Soumyajit21213/Gujarat_Robofest_Maze_Solver/PCB Design /PCB_PCB_MAZE_RUNNER_4_2024-06-20.png

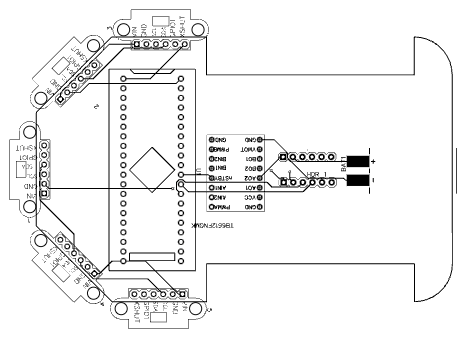
PCB Design /PCB_PCB_MAZE_RUNNER_4_2024-06-20.png
