Soumyajit21213/Gujarat_Robofest_Maze_Solver/ARDUINO CODES/Hardware Basic Codes/mpu6050/mpu6050.ino

/*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
1.0  14 January 2023 -  initial release
*/
#include <Wire.h>
float RateRoll, RatePitch, RateYaw;
float RateCalibrationRoll, RateCalibrationPitch, RateCalibrationYaw;
int RateCalibrationNumber;
#include <PulsePosition.h>
PulsePositionInput ReceiverInput(RISING);
float ReceiverValue[]={0, 0, 0, 0, 0, 0, 0, 0};
int ChannelNumber=0; 
float Voltage, Current, BatteryRemaining, BatteryAtStart;
float CurrentConsumed=0;
float BatteryDefault=1300;
uint32_t LoopTimer;
float DesiredRateRoll, DesiredRatePitch,DesiredRateYaw;
float ErrorRateRoll, ErrorRatePitch, ErrorRateYaw;
float InputRoll, InputThrottle, InputPitch, InputYaw;
float PrevErrorRateRoll, PrevErrorRatePitch, PrevErrorRateYaw;
float PrevItermRateRoll, PrevItermRatePitch, PrevItermRateYaw;
float PIDReturn[]={0, 0, 0};
float PRateRoll=0.6; float PRatePitch=PRateRoll; float PRateYaw=2;
float IRateRoll=3.5; float IRatePitch=IRateRoll; float IRateYaw=12;
float DRateRoll=0.03; float DRatePitch=DRateRoll; float DRateYaw=0;
float MotorInput1, MotorInput2, MotorInput3, MotorInput4;
float AccX, AccY, AccZ;
float AngleRoll, AnglePitch;
float KalmanAngleRoll=0, KalmanUncertaintyAngleRoll=2*2;
float KalmanAnglePitch=0, KalmanUncertaintyAnglePitch=2*2;
float Kalman1DOutput[]={0,0};
float DesiredAngleRoll, DesiredAnglePitch;
float ErrorAngleRoll, ErrorAnglePitch;
float PrevErrorAngleRoll, PrevErrorAnglePitch;
float PrevItermAngleRoll, PrevItermAnglePitch;
float PAngleRoll=2; float PAnglePitch=PAngleRoll;
float IAngleRoll=0; float IAnglePitch=IAngleRoll;
float DAngleRoll=0; float DAnglePitch=DAngleRoll;
void kalman_1d(float KalmanState, float KalmanUncertainty, float KalmanInput, float KalmanMeasurement) {
  KalmanState=KalmanState+0.004*KalmanInput;
  KalmanUncertainty=KalmanUncertainty + 0.004 * 0.004 * 4 * 4;
  float KalmanGain=KalmanUncertainty * 1/(1*KalmanUncertainty + 3 * 3);
  KalmanState=KalmanState+KalmanGain * (KalmanMeasurement-KalmanState);
  KalmanUncertainty=(1-KalmanGain) * KalmanUncertainty;
  Kalman1DOutput[0]=KalmanState; 
  Kalman1DOutput[1]=KalmanUncertainty;
}
void battery_voltage(void) {
  Voltage=(float)analogRead(15)/62;
  Current=(float)analogRead(21)*0.089;
}
void read_receiver(void){
  ChannelNumber = ReceiverInput.available();  
  if (ChannelNumber > 0) {
         for (int i=1; i<=ChannelNumber;i++){
              ReceiverValue[i-1]=ReceiverInput.read(i);
         }
  }
}
void gyro_signals(void) {
  Wire.beginTransmission(0x68);
  Wire.write(0x1A);
  Wire.write(0x05);
  Wire.endTransmission();
  Wire.beginTransmission(0x68);
  Wire.write(0x1C);
  Wire.write(0x10);
  Wire.endTransmission();
  Wire.beginTransmission(0x68);
  Wire.write(0x3B);
  Wire.endTransmission(); 
  Wire.requestFrom(0x68,6);
  int16_t AccXLSB = Wire.read() << 8 | Wire.read();
  int16_t AccYLSB = Wire.read() << 8 | Wire.read();
  int16_t AccZLSB = Wire.read() << 8 | Wire.read();
  Wire.beginTransmission(0x68);
  Wire.write(0x1B); 
  Wire.write(0x8);
  Wire.endTransmission();                                                   
  Wire.beginTransmission(0x68);
  Wire.write(0x43);
  Wire.endTransmission();
  Wire.requestFrom(0x68,6);
  int16_t GyroX=Wire.read()<<8 | Wire.read();
  int16_t GyroY=Wire.read()<<8 | Wire.read();
  int16_t GyroZ=Wire.read()<<8 | Wire.read();
  RateRoll=(float)GyroX/65.5;
  RatePitch=(float)GyroY/65.5;
  RateYaw=(float)GyroZ/65.5;
  AccX=(float)AccXLSB/4096;
  AccY=(float)AccYLSB/4096;
  AccZ=(float)AccZLSB/4096 -0.21 ;
  AngleRoll=atan(AccY/sqrt(AccX*AccX+AccZ*AccZ))*1/(3.142/180);
  AnglePitch=-atan(AccX/sqrt(AccY*AccY+AccZ*AccZ))*1/(3.142/180);
}
void pid_equation(float Error, float P , float I, float D, float PrevError, float PrevIterm) {
  float Pterm=P*Error;
  float Iterm=PrevIterm+I*(Error+PrevError)*0.004/2;
  if (Iterm > 400) Iterm=400;
  else if (Iterm <-400) Iterm=-400;
  float Dterm=D*(Error-PrevError)/0.004;
  float PIDOutput= Pterm+Iterm+Dterm;
  if (PIDOutput>400) PIDOutput=400;
  else if (PIDOutput <-400) PIDOutput=-400;
  PIDReturn[0]=PIDOutput;
  PIDReturn[1]=Error;
  PIDReturn[2]=Iterm;
}
void reset_pid(void) {
  PrevErrorRateRoll=0; PrevErrorRatePitch=0; PrevErrorRateYaw=0;
  PrevItermRateRoll=0; PrevItermRatePitch=0; PrevItermRateYaw=0;
  PrevErrorAngleRoll=0; PrevErrorAnglePitch=0;    
  PrevItermAngleRoll=0; PrevItermAnglePitch=0;
}
void setup() {
  pinMode(5, OUTPUT);
  digitalWrite(5, HIGH);
  pinMode(13, OUTPUT);
  digitalWrite(13, HIGH);   
  Wire.setClock(400000);
  Wire.begin();
  delay(250);
  Wire.beginTransmission(0x68);
  Wire.write(0x6B);
  Wire.write(0x00);
  Wire.endTransmission();
  for (RateCalibrationNumber=0; 
        RateCalibrationNumber<2000;
        RateCalibrationNumber ++) {
          gyro_signals();
    RateCalibrationRoll+=RateRoll;
    RateCalibrationPitch+=RatePitch;
    RateCalibrationYaw+=RateYaw;
    delay(1);
  }
  RateCalibrationRoll/=2000;
  RateCalibrationPitch/=2000;
  RateCalibrationYaw/=2000;
  analogWriteFrequency(1, 250);
  analogWriteFrequency(2, 250);
  analogWriteFrequency(3, 250);
  analogWriteFrequency(4, 250);
  analogWriteResolution(12,
12);
  pinMode(6, OUTPUT);
  digitalWrite(6, HIGH);
  battery_voltage();
  if (Voltage > 8.3) { digitalWrite(5, LOW); BatteryAtStart=BatteryDefault; }
  else if (Voltage < 7.5) {BatteryAtStart=30/100*BatteryDefault ;}
  else { digitalWrite(5, LOW); BatteryAtStart=(82*Voltage-580)/100*BatteryDefault; }
  ReceiverInput.begin(14);
  while (ReceiverValue[2] < 1020 || 
         ReceiverValue[2] > 1050) {
    read_receiver();
    delay(4);
  }
  LoopTimer=micros();
}
void loop() {
  gyro_signals();
  RateRoll-=RateCalibrationRoll;
  RatePitch-=RateCalibrationPitch;
  RateYaw-=RateCalibrationYaw;
  kalman_1d(KalmanAngleRoll, KalmanUncertaintyAngleRoll, RateRoll, AngleRoll);
  KalmanAngleRoll=Kalman1DOutput[0]; KalmanUncertaintyAngleRoll=Kalman1DOutput[1];
  kalman_1d(KalmanAnglePitch, KalmanUncertaintyAnglePitch, RatePitch, AnglePitch);
  KalmanAnglePitch=Kalman1DOutput[0]; KalmanUncertaintyAnglePitch=Kalman1DOutput[1];
  read_receiver();
  DesiredAngleRoll=0.10*(ReceiverValue[0]-1500);
  DesiredAnglePitch=0.10*(ReceiverValue[1]-1500);
  InputThrottle=ReceiverValue[2];
  DesiredRateYaw=0.15*(ReceiverValue[3]-1500);
  ErrorAngleRoll=DesiredAngleRoll-KalmanAngleRoll;
  ErrorAnglePitch=DesiredAnglePitch-KalmanAnglePitch;
  pid_equation(ErrorAngleRoll, PAngleRoll, IAngleRoll, DAngleRoll, PrevErrorAngleRoll, PrevItermAngleRoll);     
  DesiredRateRoll=PIDReturn[0]; 
  PrevErrorAngleRoll=PIDReturn[1];
  PrevItermAngleRoll=PIDReturn[2];
  pid_equation(ErrorAnglePitch, PAnglePitch, IAnglePitch, DAnglePitch, PrevErrorAnglePitch, PrevItermAnglePitch);
  DesiredRatePitch=PIDReturn[0]; 
  PrevErrorAnglePitch=PIDReturn[1];
  PrevItermAnglePitch=PIDReturn[2];
  ErrorRateRoll=DesiredRateRoll-RateRoll;
  ErrorRatePitch=DesiredRatePitch-RatePitch;
  ErrorRateYaw=DesiredRateYaw-RateYaw;
  pid_equation(ErrorRateRoll, PRateRoll, IRateRoll, DRateRoll, PrevErrorRateRoll, PrevItermRateRoll);
       InputRoll=PIDReturn[0];
       PrevErrorRateRoll=PIDReturn[1]; 
       PrevItermRateRoll=PIDReturn[2];
  pid_equation(ErrorRatePitch, PRatePitch,IRatePitch, DRatePitch, PrevErrorRatePitch, PrevItermRatePitch);
       InputPitch=PIDReturn[0]; 
       PrevErrorRatePitch=PIDReturn[1]; 
       PrevItermRatePitch=PIDReturn[2];
  pid_equation(ErrorRateYaw, PRateYaw,IRateYaw, DRateYaw, PrevErrorRateYaw, PrevItermRateYaw);
       InputYaw=PIDReturn[0]; 
       PrevErrorRateYaw=PIDReturn[1]; 
       PrevItermRateYaw=PIDReturn[2];/* 
  MPU6050 DMP6 ESPWiFi

  The board reads quaternion data from the MPU6050 and sends Open Sound
  Control messages.

  This example requires the WiFiManager and OSCMEssage libraries available here:
  - https://github.com/tzapu/WiFiManager
  - https://github.com/CNMAT/OSC 

  Digital Motion Processor or DMP performs complex motion processing tasks.
  - Fuses the data from the accel, gyro, and external magnetometer if applied, 
  compensating individual sensor noise and errors.
  - Detect specific types of motion without the need to continuously monitor 
  raw sensor data with a microcontroller.
  - Reduce workload on the microprocessor.
  - Output processed data such as quaternions, Euler angles, and gravity vectors.

  The code includes auto-calibration and offsets generator tasks. Different 
  output formats available.

  This code is compatible with the teapot project by using the teapot output format.

  Circuit: In addition to connection 3.3v, GND, SDA, and SCL, this sketch
  depends on the MPU6050's INT pin being connected to the board's
  external interrupt #0 pin.
    
  Find the full MPU6050 library documentation here:
  https://github.com/ElectronicCats/mpu6050/wiki

*/

#if defined(ESP8266) 
#include <ESP8266WiFi.h> // Include this library if using an ESP8266 based board
#else
#include <WiFi.h> //Otherwise use the included WiFi library
#endif

#include <DNSServer.h>
#include <WiFiClient.h>
#include <WiFiUdp.h>
#include <OSCMessage.h>
#include <WiFiManager.h>

#include "I2Cdev.h"
#include "MPU6050_6Axis_MotionApps20.h"

/* MPU6050 default I2C address is 0x68*/
MPU6050 mpu;
//MPU6050 mpu(0x69); //Use for AD0 high
//MPU6050 mpu(0x68, &Wire1); //Use for AD0 low, but 2nd Wire (TWI/I2C) object.

/* OUTPUT FORMAT DEFINITION-------------------------------------------------------------------------------------------
- Use "OUTPUT_READABLE_QUATERNION" for quaternion commponents in [w, x, y, z] format. Quaternion does not 
suffer from gimbal lock problems but is harder to parse or process efficiently on a remote host or software 
environment like Processing.

- Use "OUTPUT_READABLE_EULER" for Euler angles (in degrees) output, calculated from the quaternions coming 
from the FIFO. EULER ANGLES SUFFER FROM GIMBAL LOCK PROBLEM.

- Use "OUTPUT_READABLE_YAWPITCHROLL" for yaw/pitch/roll angles (in degrees) calculated from the quaternions
coming from the FIFO. THIS REQUIRES GRAVITY VECTOR CALCULATION.
YAW/PITCH/ROLL ANGLES SUFFER FROM GIMBAL LOCK PROBLEM.

- Use "OUTPUT_READABLE_REALACCEL" for acceleration components with gravity removed. The accel reference frame
is not compensated for orientation. +X will always be +X according to the sensor.

- Use "OUTPUT_READABLE_WORLDACCEL" for acceleration components with gravity removed and adjusted for the world
reference frame. Yaw is relative if there is no magnetometer present.

-  Use "OUTPUT_TEAPOT_OSC" for output that matches the InvenSense teapot demo. 
-------------------------------------------------------------------------------------------------------------------------------*/ 
// #define OUTPUT_TEAPOT_OSC
#define OUTPUT_READABLE_YAWPITCHROLL
//#define OUTPUT_READABLE_QUATERNION
//#define OUTPUT_READABLE_EULER
//#define OUTPUT_READABLE_REALACCEL
//#define OUTPUT_READABLE_WORLDACCEL

#ifdef OUTPUT_READABLE_EULER
float euler[3];         // [psi, theta, phi]    Euler angle container
#endif
#ifdef OUTPUT_READABLE_YAWPITCHROLL
float ypr[3];           // [yaw, pitch, roll]   Yaw/Pitch/Roll container and gravity vector
#endif

#define INTERRUPT_PIN 15 //define the INT pin on your board

/*---MPU6050 Control/Status Variables---*/
bool DMPReady = false;  // Set true if DMP init was successful
uint8_t MPUIntStatus;   // Holds actual interrupt status byte from MPU
uint8_t devStatus;      // Return status after each device operation (0 = success, !0 = error)
uint16_t packetSize;    // Expected DMP packet size (default is 42 bytes)
uint16_t FIFOCount;     // Count of all bytes currently in FIFO
uint8_t FIFOBuffer[64]; // FIFO storage buffer

/*---Orientation/Motion Variables---*/ 
Quaternion q;           // [w, x, y, z]         Quaternion container
VectorInt16 aa;         // [x, y, z]            Accel sensor measurements
VectorInt16 aaReal;     // [x, y, z]            Gravity-free accel sensor measurements
VectorInt16 aaWorld;    // [x, y, z]            World-frame accel sensor measurements
VectorFloat gravity;    // [x, y, z]            Gravity vector

const char DEVICE_NAME[] = "mpu6050";

WiFiUDP UDP;                                // A  instance to let us send and receive packets over 
const IPAddress outIp(192, 168, 1, 11);     // Remote IP to receive OSC
const unsigned int outPort = 9999;          // Remote port to receive OSC

/*------Interrupt detection routine------*/
volatile bool MPUInterrupt = false;     // Indicates whether MPU6050 interrupt pin has gone high
void ICACHE_RAM_ATTR DMPDataReady() {
  MPUInterrupt = true;
}

void mpu_setup(){
#if I2CDEV_IMPLEMENTATION == I2CDEV_ARDUINO_WIRE
  Wire.begin();
  Wire.setClock(400000); // 400kHz I2C clock. Comment this line if having compilation difficulties
#elif I2CDEV_IMPLEMENTATION == I2CDEV_BUILTIN_FASTWIRE
  Fastwire::setup(400, true);
#endif

  // Initialize device
  Serial.println(F("Initializing I2C devices..."));
  mpu.initialize();
  pinMode(INTERRUPT_PIN, INPUT);

  /*Verify connection*/
  Serial.println(F("Testing MPU6050 connection..."));
  if(mpu.testConnection() == false){
    Serial.println("MPU6050 connection failed");
    while(true);
  }
    else {
    Serial.println("MPU6050 connection successful");
  }

  /* Initializate and configure the DMP*/
  Serial.println(F("Initializing DMP..."));
  devStatus = mpu.dmpInitialize();

  /* Supply your gyro offsets here, scaled for min sensitivity */
  mpu.setXGyroOffset(0);
  mpu.setYGyroOffset(0);
  mpu.setZGyroOffset(0);
  mpu.setZAccelOffset(0);

  /* Making sure it worked (returns 0 if so) */ 
  if (devStatus == 0) {
    mpu.CalibrateAccel(6);  // Calibration Time: generate offsets and calibrate our MPU6050
    mpu.CalibrateGyro(6);
    Serial.println("These are the Active offsets: ");
    mpu.PrintActiveOffsets();
    Serial.println(F("Enabling DMP..."));   //Turning ON DMP
    mpu.setDMPEnabled(true);

    /*Enable Arduino interrupt detection*/
    Serial.print(F("Enabling interrupt detection (Arduino external interrupt "));
    Serial.print(digitalPinToInterrupt(INTERRUPT_PIN));
    Serial.println(F(")..."));
    attachInterrupt(digitalPinToInterrupt(INTERRUPT_PIN), DMPDataReady, RISING);
    MPUIntStatus = mpu.getIntStatus();

    /* Set the DMP Ready flag so the main loop() function knows it is okay to use it */
    Serial.println(F("DMP ready! Waiting for first interrupt..."));
    DMPReady = true;
    packetSize = mpu.dmpGetFIFOPacketSize(); //Get expected DMP packet size for later comparison
  } 
  else {
    Serial.print(F("DMP Initialization failed (code ")); //Print the error code
    Serial.print(devStatus);
    Serial.println(F(")"));
    // 1 = initial memory load failed
    // 2 = DMP configuration updates failed
  }
}

void mpu_loop()
{
  if (!DMPReady) return; // Stop the program if DMP programming fails.
  if (!MPUInterrupt && FIFOCount < packetSize) return; // Wait for MPU interrupt or extra packet(s) available

  /*Reset interrupt flag and get INT_STATUS byte*/
  MPUInterrupt = false;
  MPUIntStatus = mpu.getIntStatus();

  FIFOCount = mpu.getFIFOCount();  // Get current FIFO count

  /*Check for overflow (this should never happen unless our code is too inefficient)*/
  if ((MPUIntStatus & 0x10) || FIFOCount == 1024) {
    mpu.resetFIFO();     //Reset so we can continue cleanly
    Serial.println(F("FIFO overflow!"));
    //*Otherwise, check for DMP data ready interrupt (this should happen frequently)*/
  } 
  else if (MPUIntStatus & 0x02) {
    while (FIFOCount < packetSize) FIFOCount = mpu.getFIFOCount();    // Wait for correct available data length, should be a VERY short wait
    mpu.getFIFOBytes(FIFOBuffer, packetSize);    //Read a packet from FIFO
    // track FIFO count here in case there is > 1 packet available
    // (this lets us immediately read more without waiting for an interrupt)
    FIFOCount -= packetSize;
    #ifdef OUTPUT_READABLE_QUATERNION
      /* Display Quaternion values in easy matrix form: [w, x, y, z] */
      mpu.dmpGetQuaternion(&q, FIFOBuffer);
      Serial.print("quat\t");
      Serial.print(q.w);
      Serial.print("\t");
      Serial.print(q.x);
      Serial.print("\t");
      Serial.print(q.y);
      Serial.print("\t");
      Serial.println(q.z);
    #endif

    #ifdef OUTPUT_TEAPOT_OSC
      #ifndef OUTPUT_READABLE_QUATERNION
        /* Display Quaternion values in easy matrix form: [w, x, y, z] */
        mpu.dmpGetQuaternion(&q, FIFOBuffer);
      #endif
      /*Send OSC message*/
      OSCMessage msg("/imuquat");
      msg.add((float)q.w);
      msg.add((float)q.x);
      msg.add((float)q.y);
      msg.add((float)q.z);

      UDP.beginPacket(outIp, outPort);
      msg.send(UDP);
      UDP.endPacket();
      msg.empty();
    #endif

    #ifdef OUTPUT_READABLE_EULER
      /* Display Euler angles in degrees */
      mpu.dmpGetQuaternion(&q, FIFOBuffer);
      mpu.dmpGetEuler(euler, &q);
      Serial.print("euler\t");
      Serial.print(euler[0] * 180/M_PI);
      Serial.print("\t");
      Serial.print(euler[1] * 180/M_PI);
      Serial.print("\t");
      Serial.println(euler[2] * 180/M_PI);
    #endif

    #ifdef OUTPUT_READABLE_YAWPITCHROLL
      /* Display Euler angles in degrees */
      mpu.dmpGetQuaternion(&q, FIFOBuffer);
      mpu.dmpGetGravity(&gravity, &q);
      mpu.dmpGetYawPitchRoll(ypr, &q, &gravity);
      Serial.print("ypr\t");
      Serial.print(ypr[0] * 180/M_PI);
      Serial.print("\t");
      Serial.print(ypr[1] * 180/M_PI);
      Serial.print("\t");
      Serial.println(ypr[2] * 180/M_PI);
    #endif

    #ifdef OUTPUT_READABLE_REALACCEL
      /* Display real acceleration, adjusted to remove gravity */
      mpu.dmpGetQuaternion(&q, FIFOBuffer);
      mpu.dmpGetAccel(&aa, FIFOBuffer);
      mpu.dmpGetGravity(&gravity, &q);
      mpu.dmpGetLinearAccel(&aaReal, &aa, &gravity);
      Serial.print("areal\t");
      Serial.print(aaReal.x);
      Serial.print("\t");
      Serial.print(aaReal.y);
      Serial.print("\t");
      Serial.println(aaReal.z);
    #endif

    #ifdef OUTPUT_READABLE_WORLDACCEL
      /* Display initial world-frame acceleration, adjusted to remove gravity
      and rotated based on known orientation from Quaternion */
      mpu.dmpGetQuaternion(&q, FIFOBuffer);
      mpu.dmpGetAccel(&aa, FIFOBuffer);
      mpu.dmpGetGravity(&gravity, &q);
      mpu.dmpGetLinearAccel(&aaReal, &aa, &gravity);
      mpu.dmpGetLinearAccelInWorld(&aaWorld, &aaReal, &q);
      Serial.print("aworld\t");
      Serial.print(aaWorld.x);
      Serial.print("\t");
      Serial.print(aaWorld.y);
      Serial.print("\t");
      Serial.println(aaWorld.z);
    #endif
  }
}

void setup(){
  Serial.begin(115200); //115200 is required for Teapot Demo output
  Serial.println(F("\nOrientation Sensor OSC output")); Serial.println();

  /*WiFiManager*/
  WiFiManager wifiManager; // Initializate WiFi Manager
  //wifiManager.resetSettings();    //Reset saved settings

  /*Fetches ssid and pass from eeprom and tries to connect
  if it does not connect it starts an access point with the specified name
  and goes into a blocking loop awaiting configuration*/
  wifiManager.autoConnect(DEVICE_NAME);

  Serial.print(F("WiFi connected! IP address: "));
  Serial.println(WiFi.localIP());

  mpu_setup();
}

void loop(){
  if (WiFi.status() != WL_CONNECTED) {
    Serial.println();
    Serial.println("*** Disconnected from AP, rebooting ***");
    Serial.println();
    #if defined(ESP8266)
    ESP.reset();
    #else
    ESP.restart();
    #endif
  }
  mpu_loop();
}

  if (InputThrottle > 1800) InputThrottle = 1800;
  MotorInput1= 1.024*(InputThrottle-InputRoll-InputPitch-InputYaw);
  MotorInput2= 1.024*(InputThrottle-InputRoll+InputPitch+InputYaw);
  MotorInput3= 1.024*(InputThrottle+InputRoll+InputPitch-InputYaw);
  MotorInput4= 1.024*(InputThrottle+InputRoll-InputPitch+InputYaw);
  if (MotorInput1 > 2000)MotorInput1 = 1999;
  if (MotorInput2 > 2000)MotorInput2 = 1999; 
  if (MotorInput3 > 2000)MotorInput3 = 1999; 
  if (MotorInput4 > 2000)MotorInput4 = 1999;
  int ThrottleIdle=1180;
  if (MotorInput1 < ThrottleIdle) MotorInput1 = ThrottleIdle;
  if (MotorInput2 < ThrottleIdle) MotorInput2 = ThrottleIdle;
  if (MotorInput3 < ThrottleIdle) MotorInput3 = ThrottleIdle;
  if (MotorInput4 < ThrottleIdle) MotorInput4 = ThrottleIdle;
  int ThrottleCutOff=1000;
  if (ReceiverValue[2]<1050) {
    MotorInput1=ThrottleCutOff; 
    MotorInput2=ThrottleCutOff;
    MotorInput3=ThrottleCutOff; 
    MotorInput4=ThrottleCutOff;
    reset_pid();
  }
  analogWrite(1,MotorInput1);
  analogWrite(2,MotorInput2);
  analogWrite(3,MotorInput3); 
  analogWrite(4,MotorInput4);
  battery_voltage();
  CurrentConsumed=Current*1000*0.004/3600+CurrentConsumed;
  BatteryRemaining=(BatteryAtStart-CurrentConsumed)/BatteryDefault*100;
  if (BatteryRemaining<=30) digitalWrite(5, HIGH);
  else digitalWrite(5, LOW);
  while (micros() - LoopTimer < 4000);
  LoopTimer=micros();
}
