Soumyajit21213/Gujarat_Robofest_Maze_Solver/(commit log)

2025-01-26 uploaded every arduino code
2025-01-26 added the video and pcb design
