Soumyajit21213/Gujarat_Robofest_Maze_Solver/(notices)

Notices in the files:
ARDUINO CODES/Hardware Basic Codes/mpu6050/mpu6050.ino:
The text and figures in this code and instructions are licensed under a Creative Commons Attribution - Noncommercial - ShareAlike 4.0 International Public Licence.
